AllenNeuralDynamics/kicad-lib/(commit log)

2025-02-07 add photointerrupter and inductor footprints
2025-12-15 add ag1171 subscriber-line interface circuit
